halherta/TPA3122D2_Amplifier/images/TPA3122D2_AmplifierSchematic.png

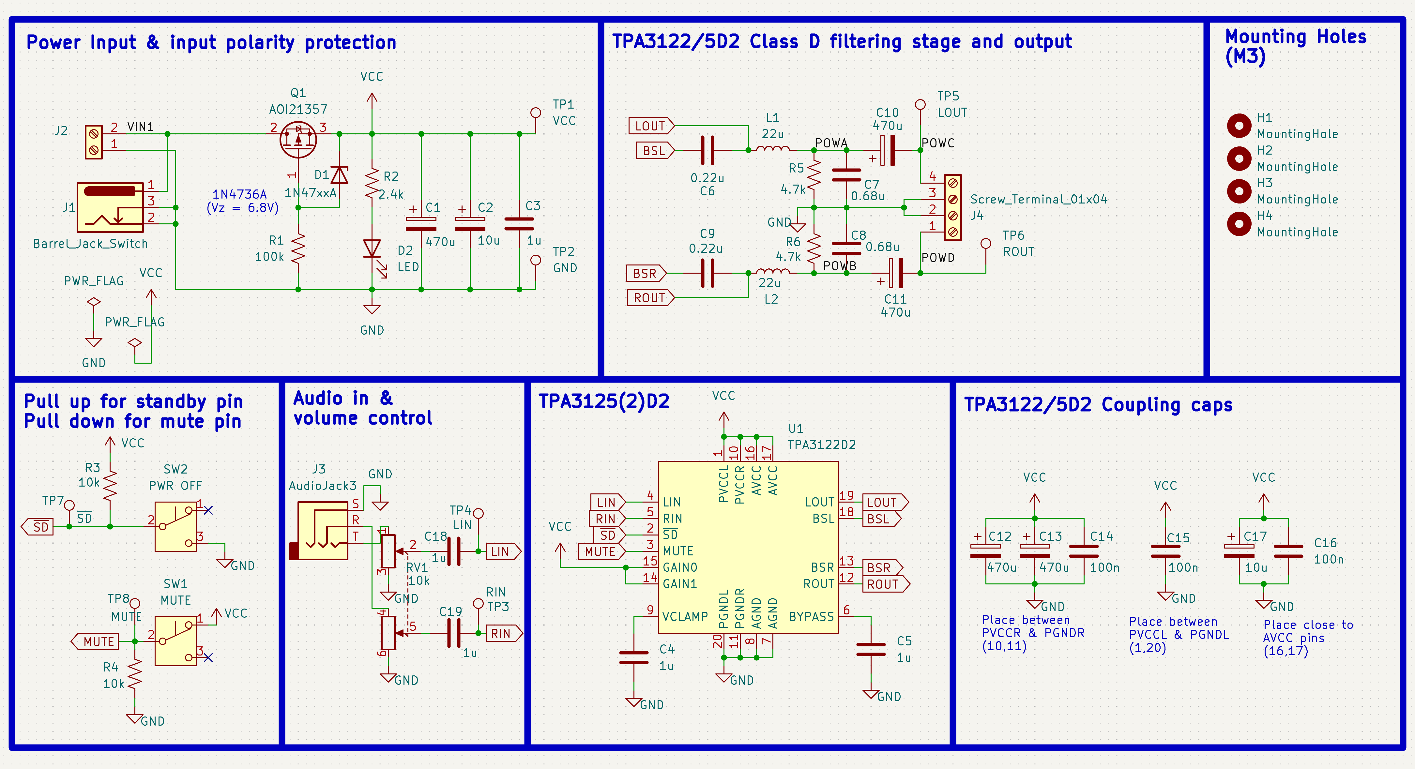
images/TPA3122D2_AmplifierSchematic.png
