halherta/TPA3122D2_Amplifier/DigikeyBom/TPA3122D2New.csv

Index | Manufacturer Part Number | Manufacturer Name | Description | Lead Time | Availability | Stock Status | Attrition % | Requested Quantity 1 | Pack Quantity 1 | Pack Type 1 | Digi-Key Part Number 1 | Unit Price 1 | Extended Price 1 | Minimum Order Quantity 1 | Product Notes
1 | 35ZLH470MEFC10X16 | Rubycon | CAP ALUM 470UF 20% 35V RADIAL TH |  | 116,274 | In Stock |  | 5 | 5 | Bulk | 1189-1890-ND | 1.26000 | $6.30 | 1
2 | FG24X7R1H105KRT06 | TDK | CAP CER 1UF 50V X7R RADIAL |  | 639 | In Stock |  | 5 | 5 | Cut Tape (CT) | 445-173374-1-ND | 0.81000 | $4.05 | 1
3 | FG24X7R1H224KNT06 | TDK | CAP CER 0.22UF 50V X7R RADIAL |  | 397 | In Stock |  | 2 | 2 | Cut Tape (CT) | 445-173377-1-ND | 0.48000 | $0.96 | 1
4 | FA24X7R1H684KRU06 | TDK | CAP CER 0.68UF 50V X7R RADIAL |  | 8,947 | In Stock |  | 2 | 2 | Cut Tape (CT) | 445-180639-1-ND | 0.94000 | $1.88 | 1
5 | FG28X7R1H104KNT06 | TDK | CAP CER 0.1UF 50V X7R RADIAL |  | 428 | In Stock |  | 3 | 3 | Cut Tape (CT) | 445-173588-1-ND | 0.40000 | $1.20 | 1
6 | 1N4740A | onsemi | DIODE ZENER 10V 1W DO41 |  | 20,395 | In Stock |  | 1 | 1 | Bulk | 1N4740A-ND | 0.42000 | $0.42 | 1
7 | 1N4736A | onsemi | DIODE ZENER 6.8V 1W DO41 |  | 40,419 | In Stock |  | 1 | 1 | Bulk | 1N4736AFS-ND | 0.45000 | $0.45 | 1
8 | WP7113ID | Kingbright | LED RED DIFFUSED T-1 3/4 T/H |  | 127,328 | In Stock |  | 1 | 1 | Bulk | 754-1264-ND | 0.34000 | $0.34 | 1
9 | PJ-102AH | Same Sky (Formerly CUI Devices) | CONN PWR JACK 2X5.5MM SOLDER |  | 62,706 | In Stock |  | 1 | 1 | Tray | CP-102AH-ND | 1.15000 | $1.15 | 1
10 | 1935776 | Phoenix Contact | TERM BLK 2POS SIDE ENTRY 5MM PCB |  | 6,090 | In Stock |  | 1 | 1 | Bulk | 277-6405-ND | 0.82000 | $0.82 | 1
11 | 1935187 | Phoenix Contact | TERM BLK 4POS SIDE ENTRY 5MM PCB |  | 10,278 | In Stock |  | 1 | 1 | Bulk | 277-1579-ND | 1.54000 | $1.54 | 1
12 | SJ1-3523N | Same Sky (Formerly CUI Devices) | CONN JACK STEREO 3.5MM R/A |  | 232,242 | In Stock |  | 1 | 1 | Tray | CP1-3523N-ND | 1.68000 | $1.68 | 1
13 | DRC-V-220K | Signal Transformer | FIXED IND 22UH 2.55A 70 MOHM TH |  | 1,433 | In Stock |  | 2 | 2 | Tray | 595-DRC-V-220K-ND | 1.05000 | $2.10 | 1
14 | AOI21357 | Alpha & Omega Semiconductor Inc. | MOSFET P-CH 30V 23A/70A TO251A |  | 19,062 | In Stock |  | 1 | 1 | Tube | 785-1836-ND | 3.08000 | $3.08 | 1
15 | TPA3122D2N | Texas Instruments | IC AUDIO AMP D 20-PDIP |  | 506 | In Stock |  | 1 | 1 | Tube | 296-23375-5-ND | 8.75000 | $8.75 | 1
16 | PTD902-2015K-B103 | Bourns Inc. | POT 10K OHM 1/20W CARBON LINEAR |  | 1,459 | In Stock |  | 1 | 1 | Tray | PTD902-2015K-B103-ND | 4.39000 | $4.39 | 1
17 | RNF14FTD100K | Stackpole Electronics Inc | RES 100K OHM 1% 1/4W AXIAL |  | 10,193 | In Stock |  | 1 | 1 | Cut Tape (CT) | RNF14FTD100KCT-ND | 0.15000 | $0.15 | 1
18 | MFR-25FTE52-2K4 | YAGEO | RES 2.4K OHM 1% 1/4W AXIAL |  | 3,961 | In Stock |  | 1 | 1 | Cut Tape (CT) | 13-MFR-25FTE52-2K4CT-ND | 0.15000 | $0.15 | 1
19 | MFR-25FTF52-4K7 | YAGEO | RES 4.7K OHM 1% 1/4W AXIAL |  | 9,732 | In Stock |  | 1 | 1 | Cut Tape (CT) | 13-MFR-25FTF52-4K7CT-ND | 0.16000 | $0.16 | 1
20 | MFR-25FRF52-10K | YAGEO | RES 10K OHM 1% 1/4W AXIAL |  | 229,961 | In Stock |  | 2 | 2 | Cut Tape (CT) | 13-MFR-25FRF52-10KCT-ND | 0.15000 | $0.30 | 1
21 | ECA-1VM100I | Panasonic Industry | CAP ALUM 10UF 20% 35V RADIAL TH |  | 830 | In Stock |  | 2 | 2 | Cut Tape (CT) | P19549CT-ND | 0.37000 | $0.74 | 1
22 | EG1224 | E-Switch | SWITCH SLIDE SPDT 500MA 15V |  | 7,987 | In Stock |  | 2 | 2 | Bulk | EG2585-ND | 1.50000 | $3.00 | 1
