halherta/TPA3122D2_Amplifier/TPA3122D2_Amplifier.csv

Reference | Value | Datasheet | Footprint | Qty | DNP
C1,C10,C11,C12,C13 | 470u |  | Capacitor_THT:CP_Radial_D10.0mm_P5.00mm | 5
C2,C17 | 10u |  | Capacitor_THT:CP_Radial_D5.0mm_P2.50mm | 2
C3,C4,C5,C18,C19 | 1u |  | Capacitor_THT:C_Disc_D4.3mm_W1.9mm_P5.00mm | 5
C6,C9 | 0.22u |  | Capacitor_THT:C_Disc_D4.3mm_W1.9mm_P5.00mm | 2
C7,C8 | 0.68u |  | Capacitor_THT:C_Disc_D4.3mm_W1.9mm_P5.00mm | 2
C14,C15,C16 | 100n |  | Capacitor_THT:C_Disc_D4.3mm_W1.9mm_P5.00mm | 3
D1 | 1N47xxA | https://www.vishay.com/docs/85816/1n4728a.pdf | Diode_THT:D_DO-41_SOD81_P10.16mm_Horizontal | 1
D2 | LED |  | LED_THT:LED_D5.0mm | 1
J1 | Barrel_Jack_Switch |  | Connector_BarrelJack:BarrelJack_CUI_PJ-102AH_Horizontal | 1
J2 | Screw_Terminal_01x02 |  | TerminalBlock_Phoenix:TerminalBlock_Phoenix_MKDS-1,5-2_1x02_P5.00mm_Horizontal | 1
J3 | AudioJack3 |  | myparts:Jack_3.5mm_CUI_SJ1-3523N_Horizontal | 1
J4 | Screw_Terminal_01x04 |  | TerminalBlock_Phoenix:TerminalBlock_Phoenix_MKDS-1,5-4_1x04_P5.00mm_Horizontal | 1
L1,L2 | 22u |  | Inductor_THT:L_Radial_D10.0mm_P5.00mm_Fastron_07M | 2
Q1 | AOI21357 |  | Package_TO_SOT_THT:TO-251-3_Vertical | 1
R1 | 100k |  | Resistor_THT:R_Axial_DIN0207_L6.3mm_D2.5mm_P10.16mm_Horizontal | 1
R2 | 2.4k |  | Resistor_THT:R_Axial_DIN0207_L6.3mm_D2.5mm_P10.16mm_Horizontal | 1
R3,R4,RV1 | 10k |  | Resistor_THT:R_Axial_DIN0207_L6.3mm_D2.5mm_P10.16mm_Horizontal,myparts:PTD902-2015K-B103 | 3
R5,R6 | 4.7k |  | Resistor_THT:R_Axial_DIN0207_L6.3mm_D2.5mm_P10.16mm_Horizontal | 2
SW1,TP8 | MUTE |  | Button_Switch_THT:SW_E-Switch_EG1224_SPDT_Angled,TestPoint:TestPoint_THTPad_D2.0mm_Drill1.0mm | 2
SW2 | PWR OFF |  | Button_Switch_THT:SW_E-Switch_EG1224_SPDT_Angled | 1
TP1 | VCC |  | TestPoint:TestPoint_THTPad_D2.0mm_Drill1.0mm | 1
TP2 | GND |  | TestPoint:TestPoint_THTPad_D2.0mm_Drill1.0mm | 1
TP3 | RIN |  | TestPoint:TestPoint_THTPad_D2.0mm_Drill1.0mm | 1
TP4 | LIN |  | TestPoint:TestPoint_THTPad_D2.0mm_Drill1.0mm | 1
TP5 | LOUT |  | TestPoint:TestPoint_THTPad_D2.0mm_Drill1.0mm | 1
TP6 | ROUT |  | TestPoint:TestPoint_THTPad_D2.0mm_Drill1.0mm | 1
TP7 | ~{SD} |  | TestPoint:TestPoint_THTPad_D2.0mm_Drill1.0mm | 1
U1 | TPA3122D2 |  | Package_DIP:DIP-20_W7.62mm_LongPads | 1
