halherta/TPA3122D2_Amplifier/TPA3122D2_Amplifier.pdf

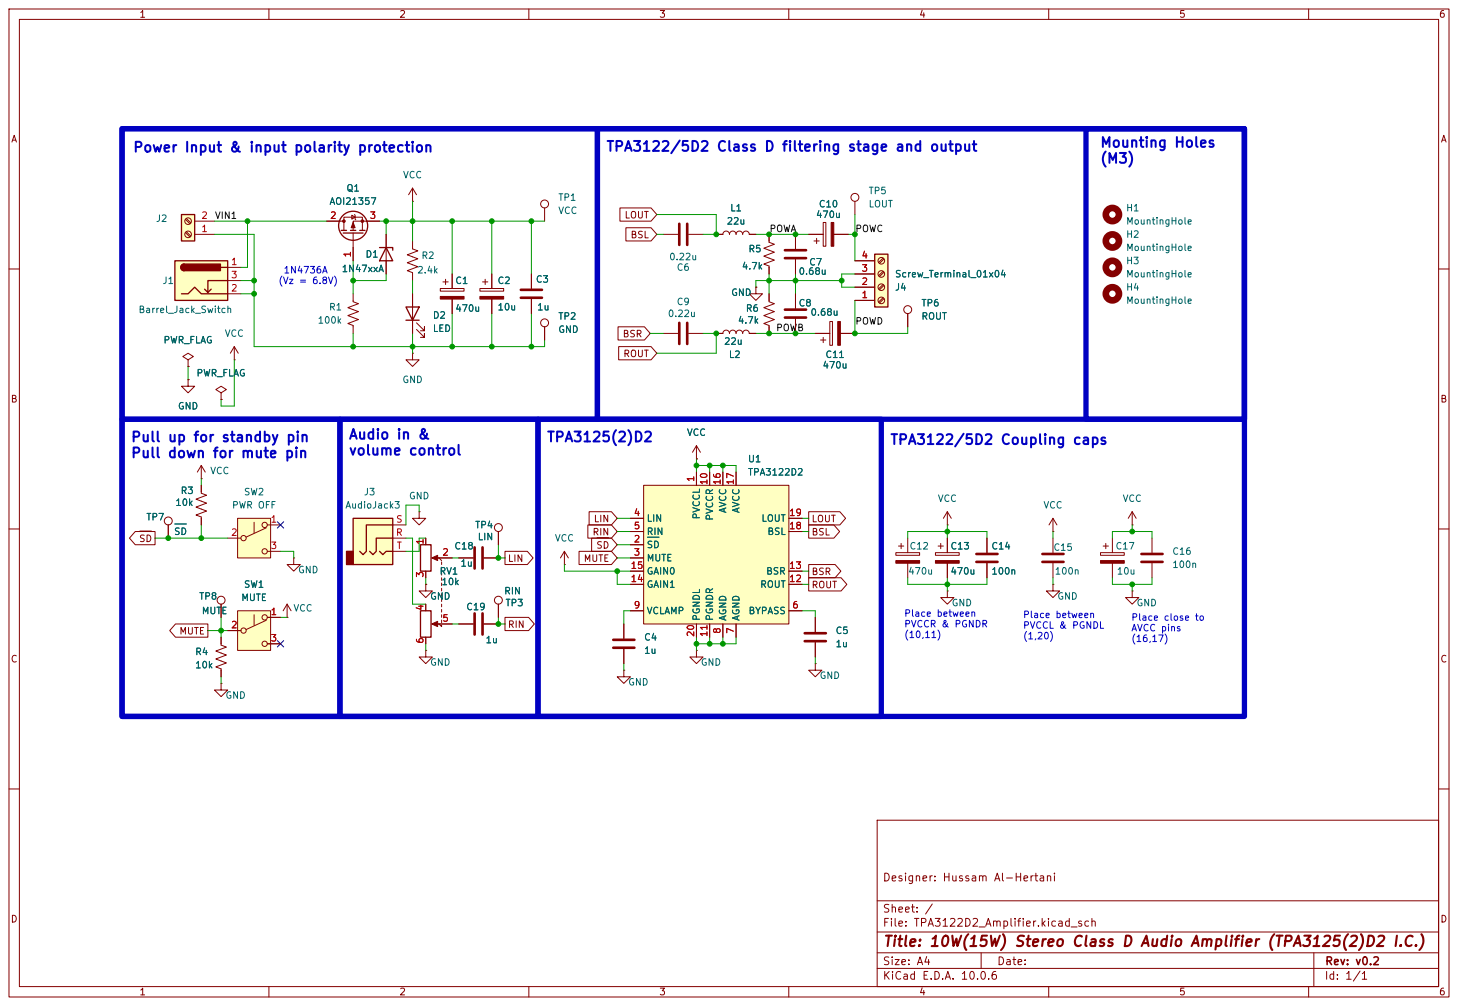
[picture p5: page 1]

POWB Power Input & input polarity protection

VCC | TP5 4 U1 | Mounting Holes (M3)

TPA3122/5D2 Class D filtering stage and output C8
LOUT ROUT LIN

GND
Pull up for standby pin
Pull down for mute pin

Designer: Hussam Al-Hertani GND
(1,20) Place between PVCCR & PGNDR

Place between PVCCL & PGNDL

Sheet: /
File: TPA3122D2_Amplifier.kicad_sch
Title: 10W(15W) Stereo Class D Audio Amplifier (TPA3125(2)D2 I.C.)

Size: A4 | Rev: v0.2
KiCad E.D.A. 10.0.6 | Id: 1/1
