halherta/TPA3122D2_Amplifier/TPA3122D2_Amplifier.kicad_pcb

## KiCad design TPA3122D2_Amplifier.kicad_pcb (2026-10-11)

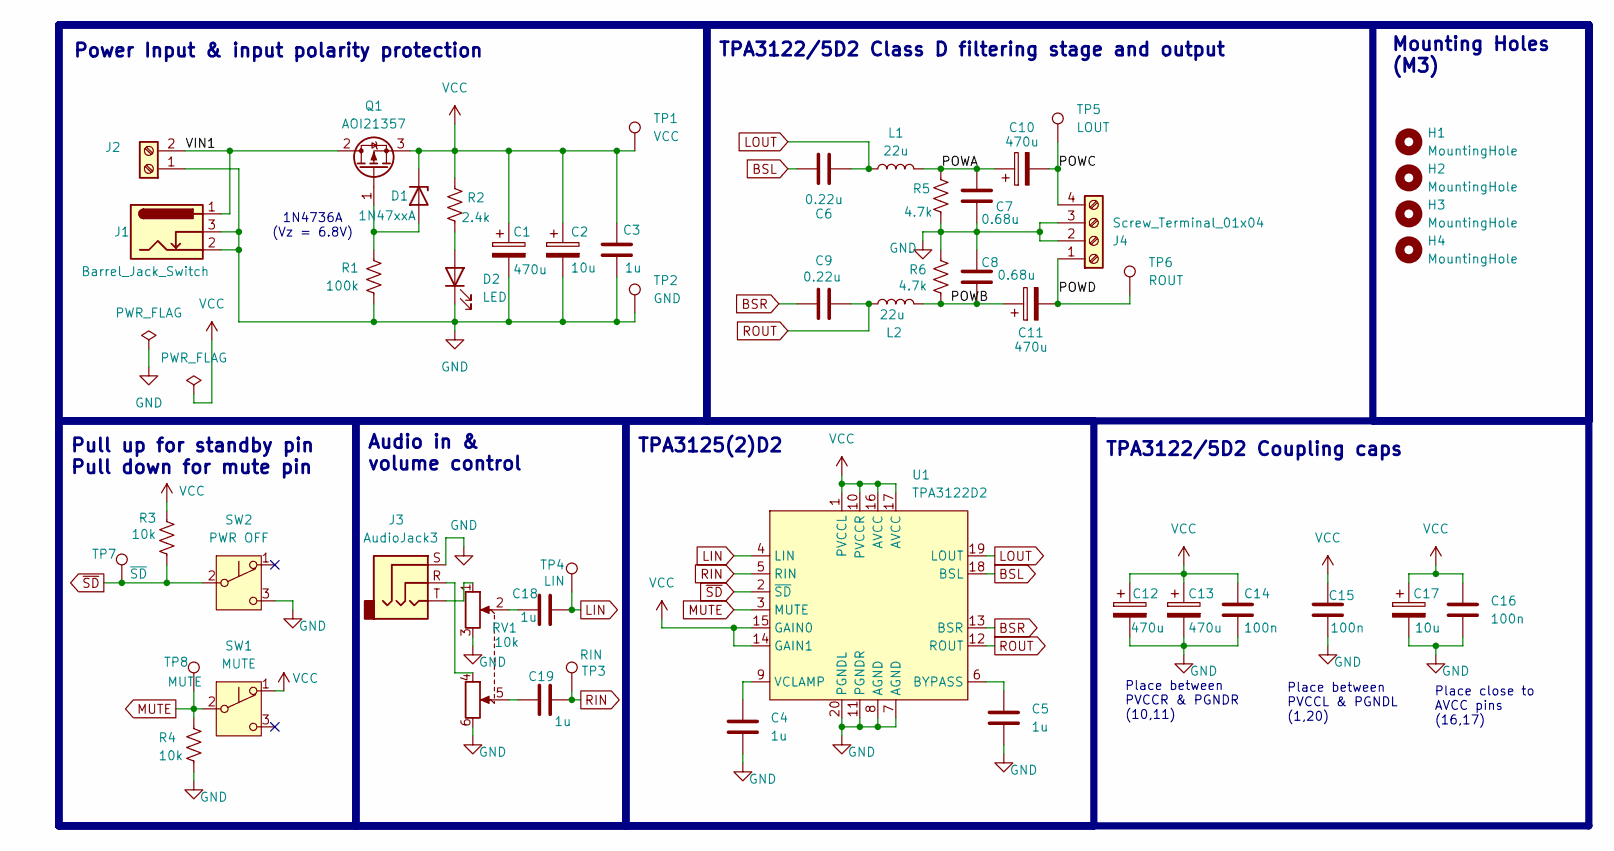
[picture p6: schematic TPA3122D2_Amplifier.kicad_sch, 10W(15W) Stereo Class D Audio Amplifier (TPA3125(2)D2 I.C.)]

Parts:
C1, C10, C11, C12, C13: 470u; CP_Radial_D10.0mm_P5.00mm
C2, C17: 10u; CP_Radial_D5.0mm_P2.50mm
C3, C4, C5, C18, C19: 1u; C_Disc_D4.3mm_W1.9mm_P5.00mm
C6, C9: 0.22u; C_Disc_D4.3mm_W1.9mm_P5.00mm
C7, C8: 0.68u; C_Disc_D4.3mm_W1.9mm_P5.00mm
C14, C15, C16: 100n; C_Disc_D4.3mm_W1.9mm_P5.00mm
D1: 1N47xxA; D_DO-41_SOD81_P10.16mm_Horizontal
D2: LED; LED_D5.0mm
H1, H2, H3, H4: MountingHole; MountingHole_3.2mm_M3
J1: Barrel_Jack_Switch; BarrelJack_CUI_PJ-102AH_Horizontal
J2: Screw_Terminal_01x02; TerminalBlock_Phoenix_MKDS-1,5-2_1x02_P5.00mm_Horizontal
J3: AudioJack3; Jack_3.5mm_CUI_SJ1-3523N_Horizontal
J4: Screw_Terminal_01x04; TerminalBlock_Phoenix_MKDS-1,5-4_1x04_P5.00mm_Horizontal
L1, L2: 22u; L_Radial_D10.0mm_P5.00mm_Fastron_07M
Q1: AOI21357; TO-251-3_Vertical
R1: 100k; R_Axial_DIN0207_L6.3mm_D2.5mm_P10.16mm_Horizontal
R2: 2.4k; R_Axial_DIN0207_L6.3mm_D2.5mm_P10.16mm_Horizontal
R3, R4: 10k; R_Axial_DIN0207_L6.3mm_D2.5mm_P10.16mm_Horizontal
R5, R6: 4.7k; R_Axial_DIN0207_L6.3mm_D2.5mm_P10.16mm_Horizontal
RV1: 10k; PTD902-2015K-B103
SW1: MUTE; SW_E-Switch_EG1224_SPDT_Angled
SW2: PWR OFF; SW_E-Switch_EG1224_SPDT_Angled
TP1: VCC; TestPoint_THTPad_D2.0mm_Drill1.0mm
TP2: GND; TestPoint_THTPad_D2.0mm_Drill1.0mm
TP3: RIN; TestPoint_THTPad_D2.0mm_Drill1.0mm
TP4: LIN; TestPoint_THTPad_D2.0mm_Drill1.0mm
TP5: LOUT; TestPoint_THTPad_D2.0mm_Drill1.0mm
TP6: ROUT; TestPoint_THTPad_D2.0mm_Drill1.0mm
TP7: ~{SD}; TestPoint_THTPad_D2.0mm_Drill1.0mm
TP8: MUTE; TestPoint_THTPad_D2.0mm_Drill1.0mm
U1: TPA3122D2; DIP-20_W7.62mm_LongPads

Connections:
/POWA: C7.1, C10.1, L1.2, R5.1
/POWB: C8.2, C11.1, L2.2, R6.2
/POWC: C10.2, J4.4, TP5.1 (1_1)
/POWD: C11.2, J4.1, TP6.1 (1_1)
/VIN1: J1.1, J2.2, Q1.2 (D)
BSL: C6.2, U1.18 (BSL)
BSR: C9.2, U1.13 (BSR)
GND: C1.2, C2.2, C3.2, C4.2, C5.2, C7.2, C8.1, C12.2, C13.2, C14.2, C15.2, C16.2, C17.2, D2.1 (K), J1.2, J1.3, J2.1, J3.S, J4.2, J4.3, R1.2, R4.2, R5.2, R6.1, RV1.3, RV1.6, SW2.3 (C), TP2.1 (1_1), U1.7 (AGND), U1.8 (AGND), U1.11 (PGNDR), U1.20 (PGNDL)
LIN: C18.2, TP4.1 (1_1), U1.4 (LIN)
LOUT: C6.1, L1.1, U1.19 (LOUT)
MUTE: R4.1, SW1.2 (B), TP8.1 (1_1), U1.3 (MUTE)
unnamed: C18.1, RV1.2
unnamed: C19.1, RV1.5
unnamed: D1.2 (A), Q1.1 (G), R1.1
unnamed: D2.2 (A), R2.2
unnamed: J3.R, RV1.4
unnamed: J3.T, RV1.1
unnamed: C5.1, U1.6 (BYPASS)
unnamed: C4.1, U1.9 (VCLAMP)
RIN: C19.2, TP3.1 (1_1), U1.5 (RIN)
ROUT: C9.1, L2.1, U1.12 (ROUT)
VCC: C1.1, C2.1, C3.1, C12.1, C13.1, C14.1, C15.1, C16.1, C17.1, D1.1 (K), Q1.3 (S), R2.1, R3.1, SW1.1 (A), TP1.1 (1_1), U1.1 (PVCCL), U1.10 (PVCCR), U1.14 (GAIN1), U1.15 (GAIN0), U1.16 (AVCC), U1.17 (AVCC)
~SD: R3.2, SW2.2 (B), TP7.1 (1_1), U1.2 (~SD)

Notes on the sheet:
1N4736A (Vz = 6.8V)
Audio in & volume control
Power Input & input polarity protection
TPA3122/5D2 Coupling caps
Mounting Holes (M3)
TPA3125(2)D2
Place between PVCCR & PGNDR (10,11)
Place between PVCCL & PGNDL (1,20)
Place close to AVCC pins (16,17)
TPA3122/5D2 Class D filtering stage and output
Pull up for standby pin Pull down for mute pin

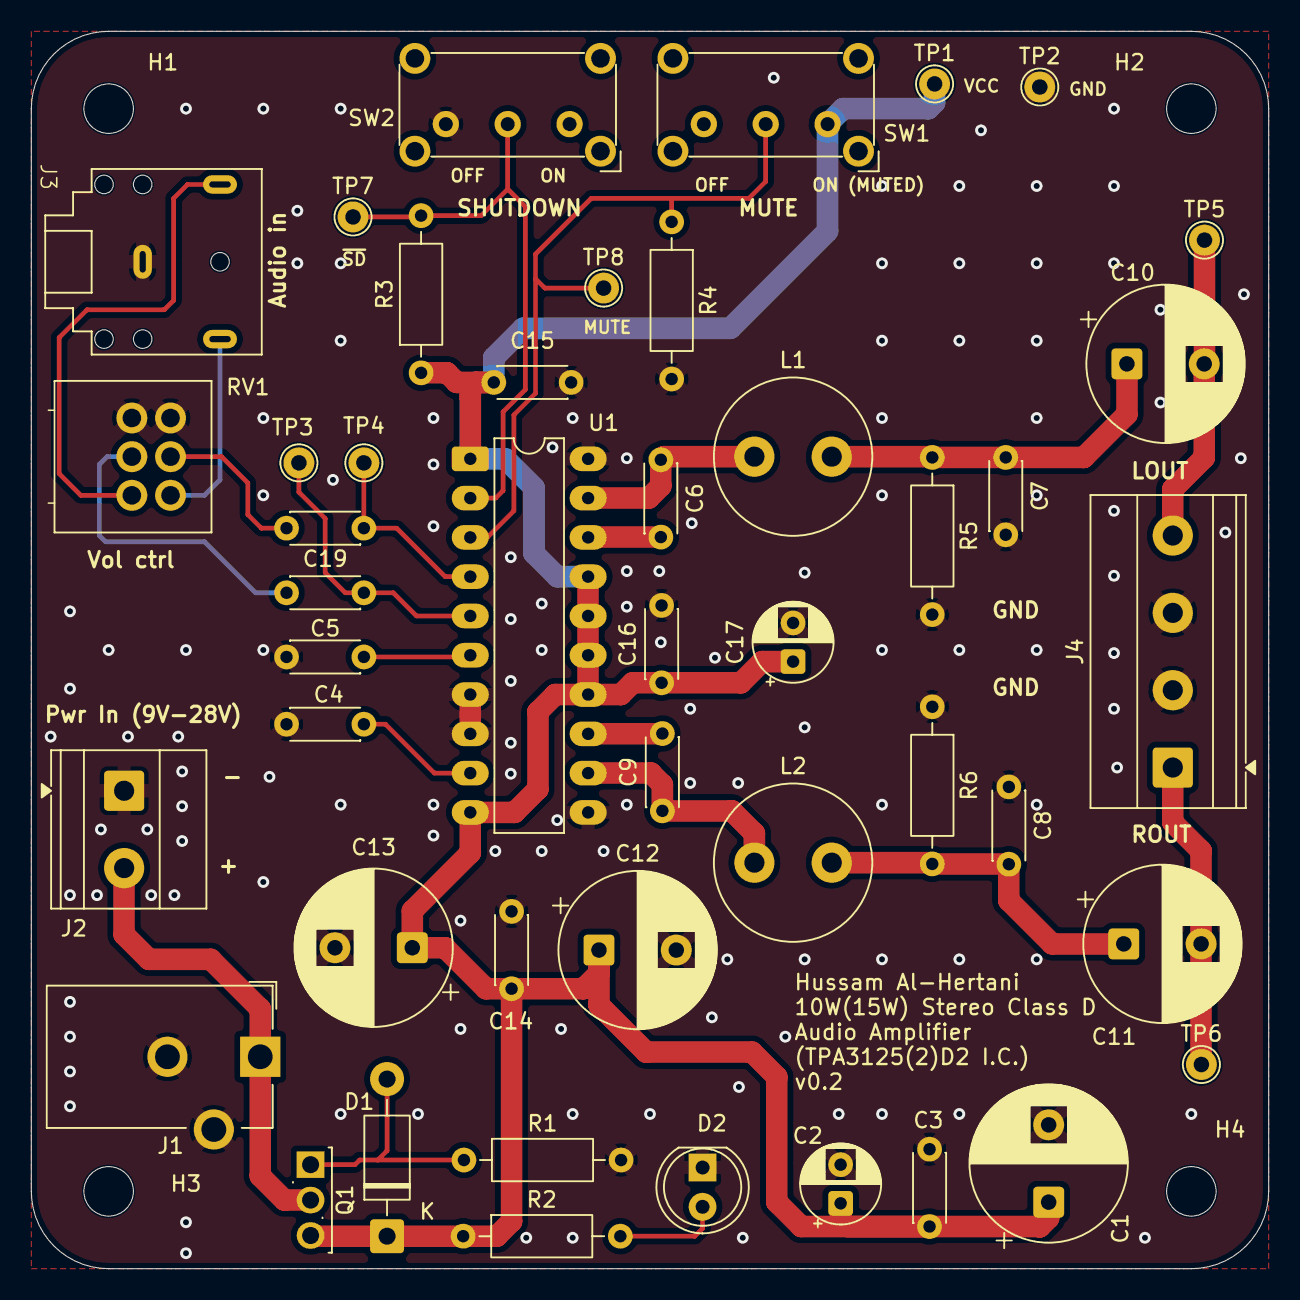
[picture p7: board TPA3122D2_Amplifier.kicad_pcb from above]

Board: 2 copper layers, 80.0 x 80.0 mm, 50 parts (0 on the bottom side), 23 nets.
