halherta/TPA3122D2_Amplifier/(commit log)

2024-11-07 fixed misplaced capacitors C6 & C9
    [TPA3122D2_Amplifier.kicad_pcb, TPA3122D2_Amplifier.kicad_sch]
2025-09-22 updated audio connector
    [TPA3122D2New.csv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]
2025-09-22 fixed terminal blocks
    [TPA3122D2_Amplifier.kicad_pcb, TPA3122D2_Amplifier.kicad_sch]
2026-10-11 Fix link formatting for schematic in README
2026-10-11 Modify image tag for board photo in README
    Updated the image tag in README.md to set width.
2026-10-11 Fix schematic link in README
    Updated the link to the schematic SVG file in the README.
2026-10-11 Update schematic image link in README
2026-10-11 Fix image links and schematic references in README
    Updated image links and schematic references in README.
2026-10-11 Add high-quality schematic links to README
    Added links to high-quality PDF and SVG versions of the schematic.
2026-10-11 Fix formatting for schematic links in README
